Elecrow-RD/Elecrow-nRFLRCC68-Wireless-Transceiver-Module/readme.md

### 1, Product picture

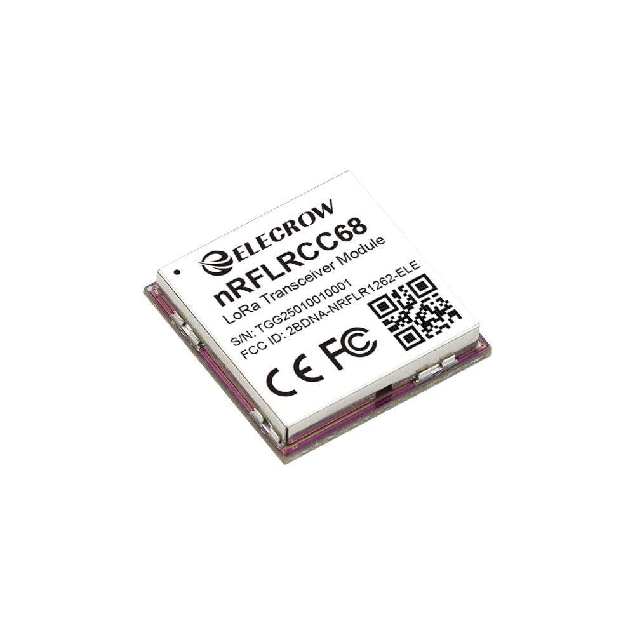
[picture p1: nrflrcc68_wireless_transceiver_module1.jpg]
nrflrcc68_wireless_transceiver_module1


link:

https://www.elecrow.com/nrflrcc68-wireless-transceiver-module-integrates-nordic-nrf52840-and-semtech-llcc68.html

### 2, Product version number

| | Hardware | Software | Remark |
| ---- | --- | --- | --- |
| 1 | V1.0 | V1.0 | latest |

### 3, product information

| Processor | nRF52840 processor, dual-core 32-bit, 64MHz main frequency |
| --- | --- |
| RF chip | Semtech LLCC68 Chip |
| LoRa Specification | |
| Transmit Power TX | +20 dBm@Max |
| Receiving Sensitivity | -125.5dBm |
| Link Budget | Support 151db link budget |
| Demodulator | Support LoRa/(G)FSK signal modulation |
| LoRa Frequency Range | Support 150MHz-960MHz configuration |
| Spreading Factor | SF5~SF11 |
| Data Transfer Rate | Supports data transmission rates from 1.76 to 62.5 Kbps |
| Other | |
| Frequency | Covering 850~930MHz (applicable to 868MHz, 915MHz) |
| Communication Interface | SPI(0~10Mbps) |
| Lead Pin | Such as SPI signal, VCC, multiple GND, NRST, ANT, TX control, RX control, BUSY status, NFC, SWD debugging pin, etc. |
| Antenna | Not onboard, via RF pins |
| Reference Power Consumption | 5uA (sleep), 120mA (transmit + MCU), 12mA (receive + MCU) |
| Communication Distance | 5~6km, maximum over 10km |
| Crystal Type | Industrial grade 32MHz TCXO |
| LoRaWAN Protocol | Class A/B/C (compliant with LoRaWAN 1.0.3 specification) |
| Operating Voltage | 1.8~3.7V |
| Operating Temperature | -40℃~+85℃, Industrial standard design |
| Package Size | 20*20*3.5mm, 80-Pin, SMT patch, LGA package; |
| Weight | 3g |

### 4,Folder structure.

|--Datasheet: Includes datasheets for components used in the project, providing detailed specifications, electrical characteristics, and pin configurations.

|--example: Provides example code and projects to demonstrate how to use the hardware and libraries. These examples help users get started quickly.

|--factory_firmware: Stores pre-compiled factory firmware that can be directly flashed onto the device. This ensures the device runs the default functionality.

|--lora development board：Schematic diagram of the expansion board of the module, customers can refer to for designing.

### 5,Pin definition

**IO port definition**

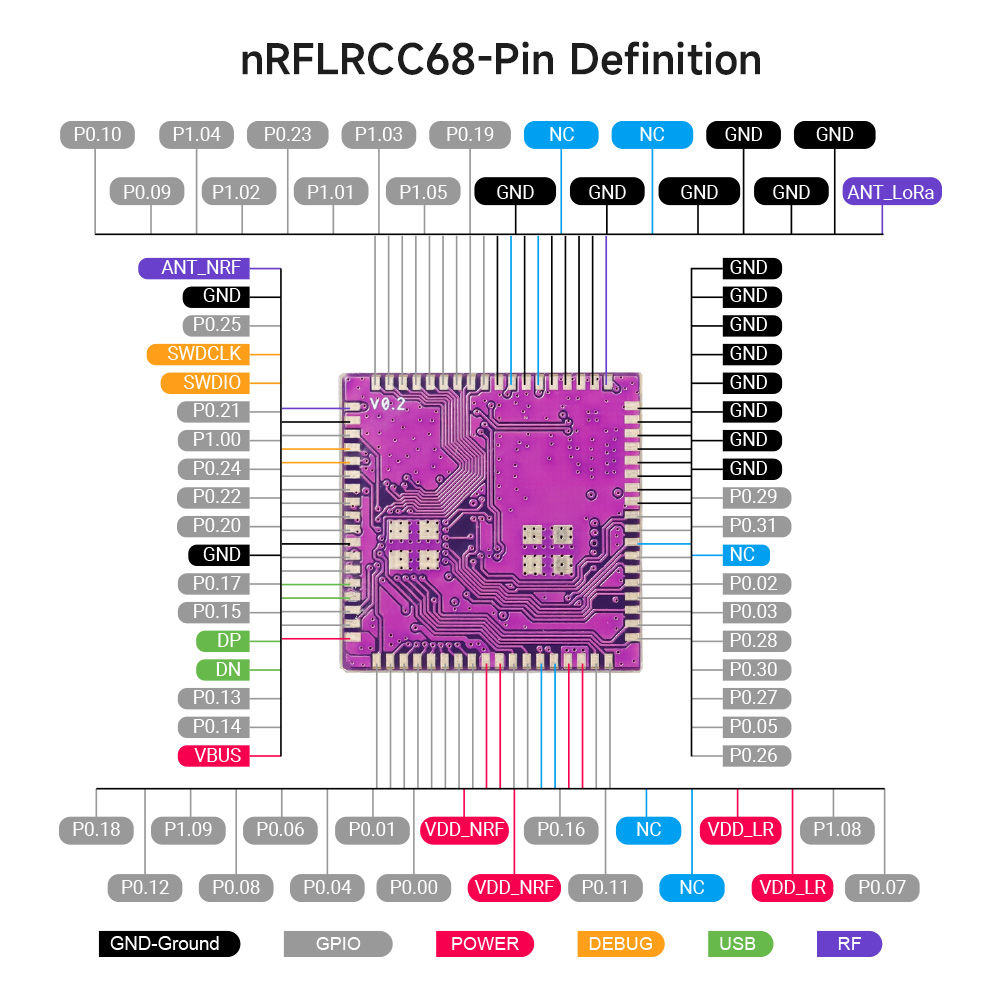
[picture p2: nrflrcc68_wireless_transceiver_module2.jpg]
nrflrcc68_wireless_transceiver_module2


##### Diagram:

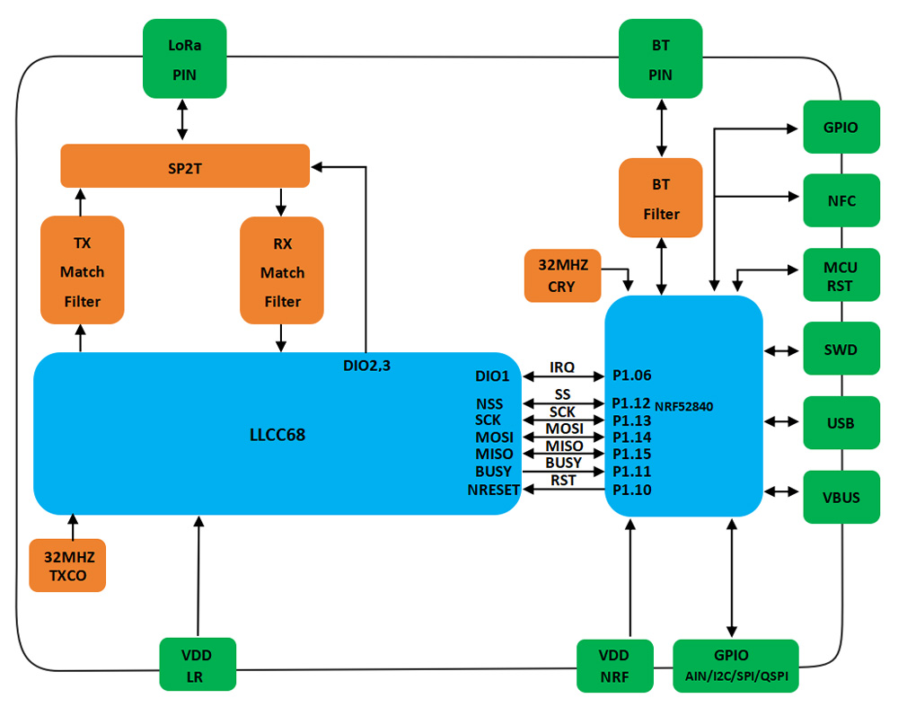
[picture p3: nrflrcc68_wireless_transceiver_module3.jpg]
nrflrcc68_wireless_transceiver_module3
