Elecrow-RD/Elecrow-nRFLRCC68-Wireless-Transceiver-Module/factory_firmware/readme.md

### firmware burning method

##### Press the boot button, plug the pico screen into the computer USB, pop up the disk drive letter



##### Just copy the firmware.uf2 file to the disk drive above

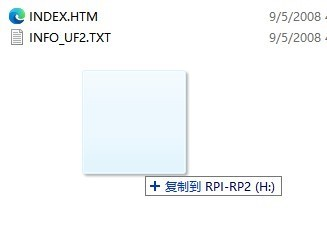
[picture p4: factory_firmware/2.jpg]
