Elecrow-RD/Elecrow-nRFLRCC68-Wireless-Transceiver-Module/Dimension_figure/nrflrcc68_wireless_transceiver_module4.jpg

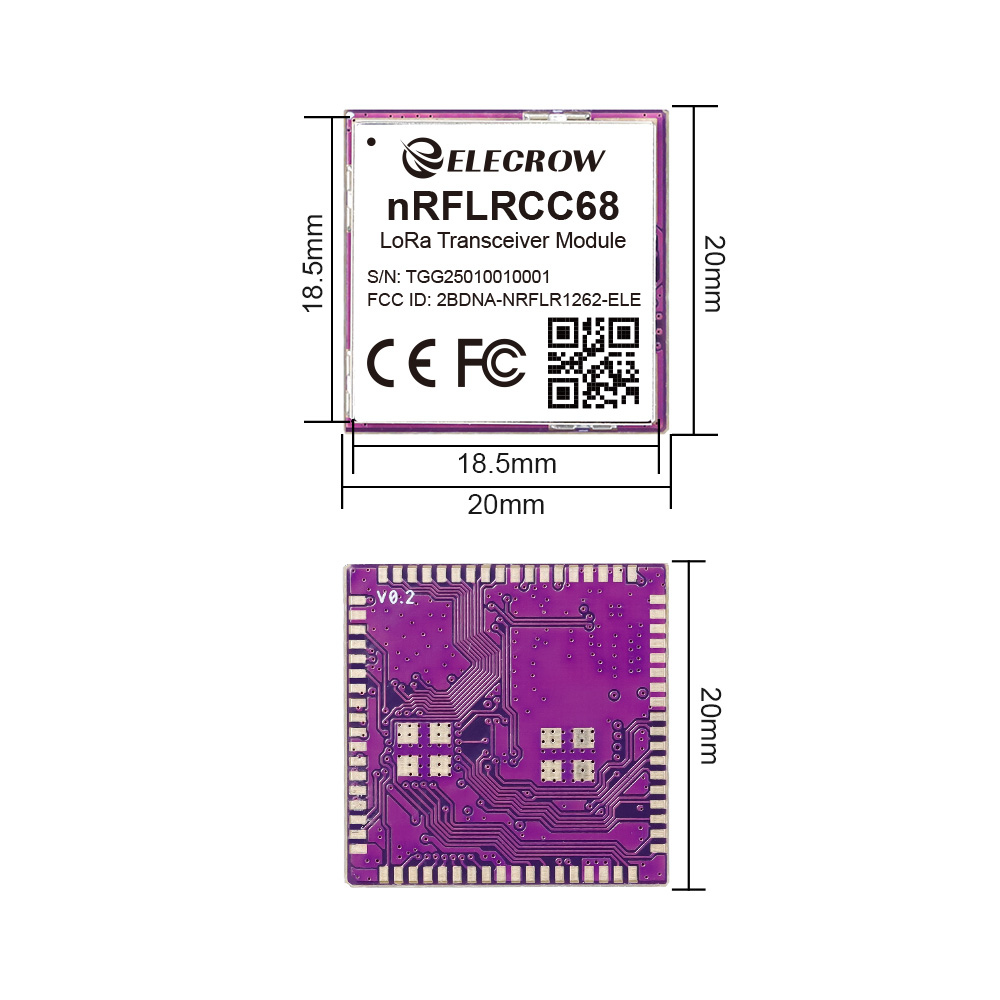
Dimension_figure/nrflrcc68_wireless_transceiver_module4.jpg
